Abdelwadoud-ben-kridis/smar-self-balancing-robot/images/angle.png

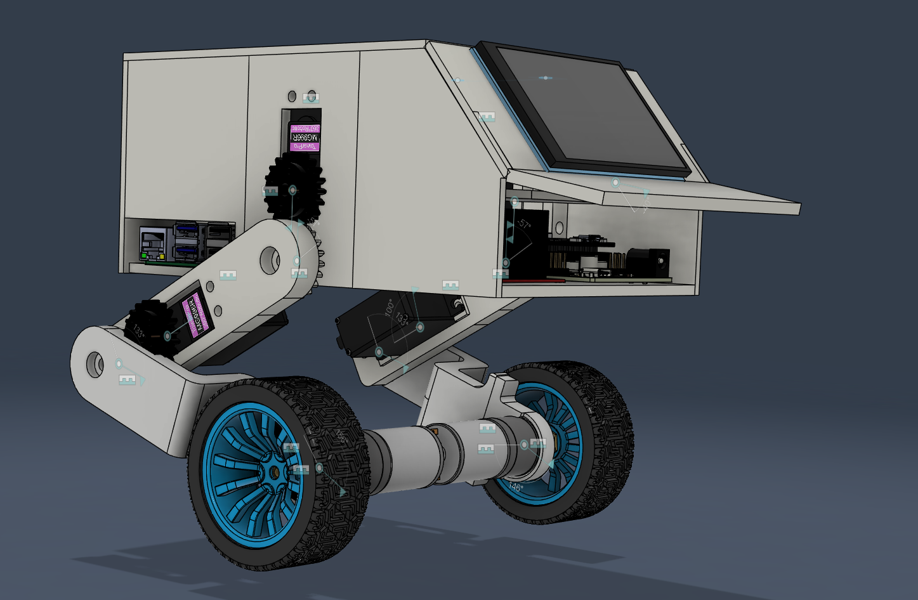
images/angle.png
