Abdelwadoud-ben-kridis/smar-self-balancing-robot/images/front.png

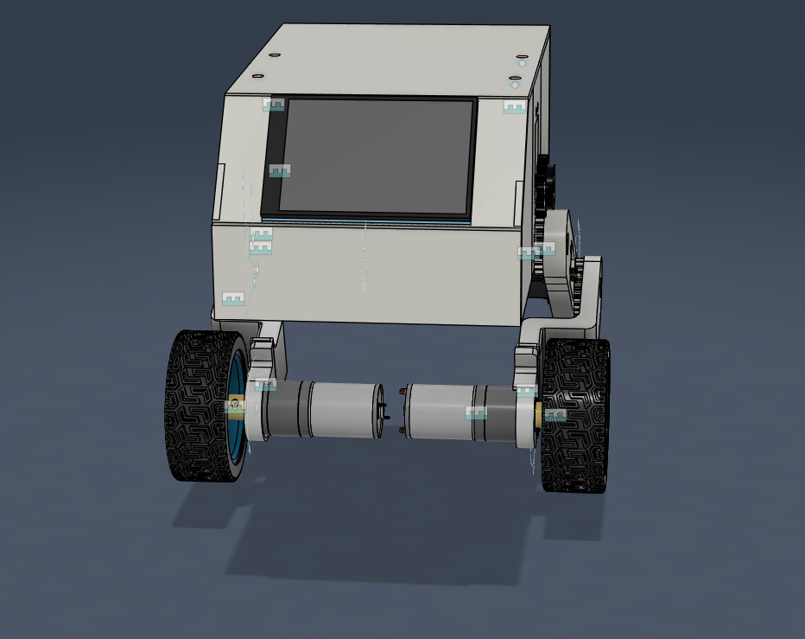
images/front.png
