Abdelwadoud-ben-kridis/smar-self-balancing-robot/images/rear.png

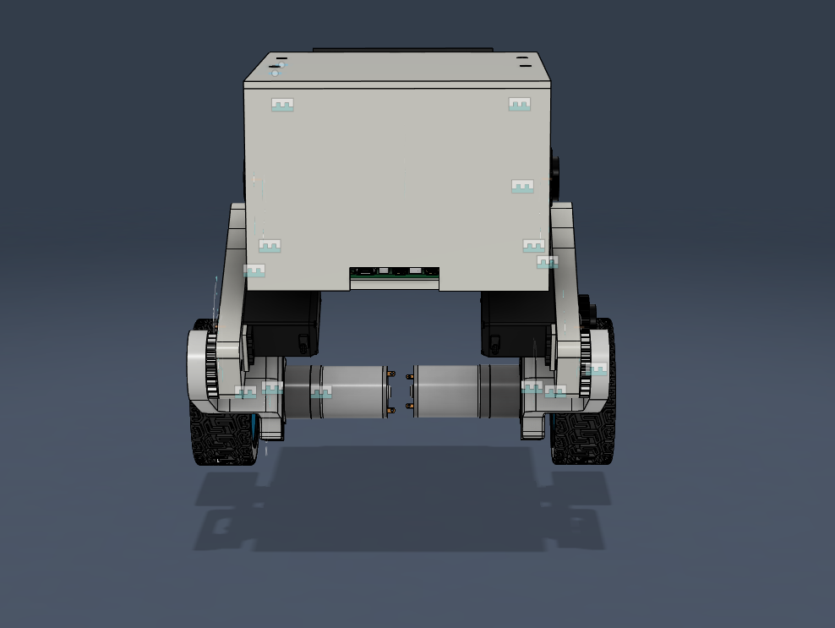
images/rear.png
