Abdelwadoud-ben-kridis/smar-self-balancing-robot/images/side-sitting.png

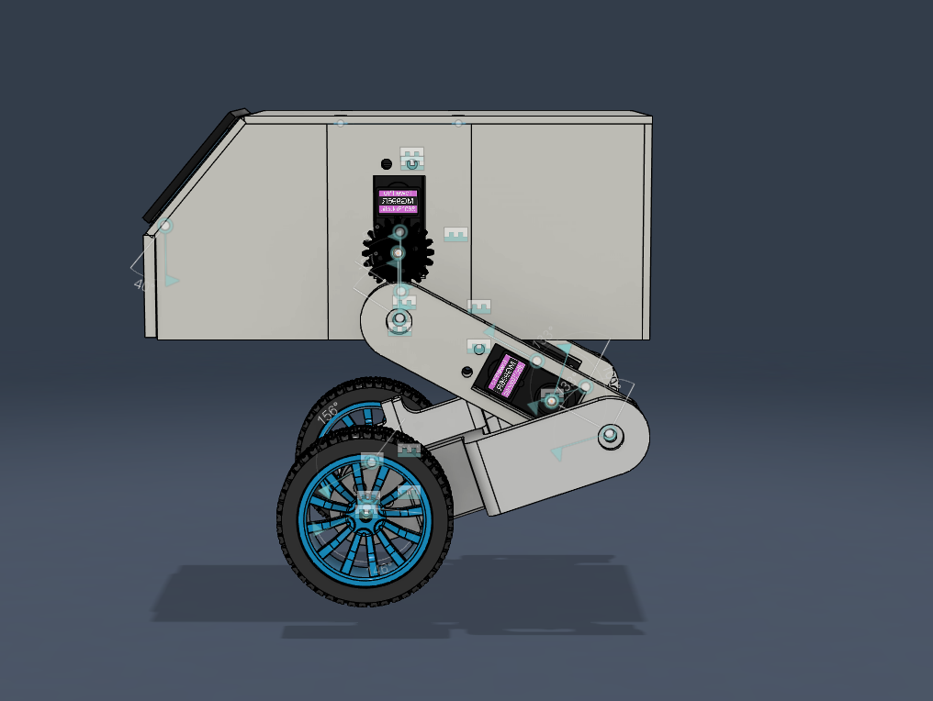
images/side-sitting.png
