Abdelwadoud-ben-kridis/smar-self-balancing-robot/images/side-standing.png

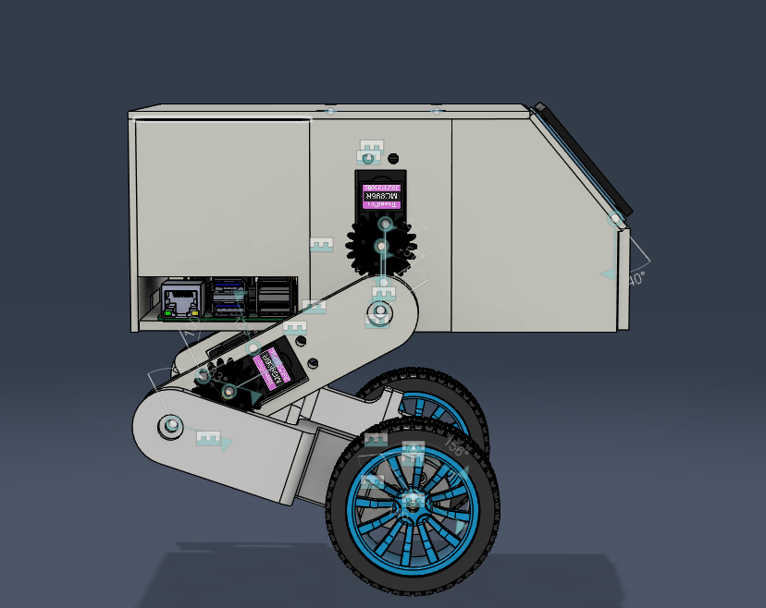
images/side-standing.png
