Abdelwadoud-ben-kridis/smar-self-balancing-robot/images/standing-clean.png

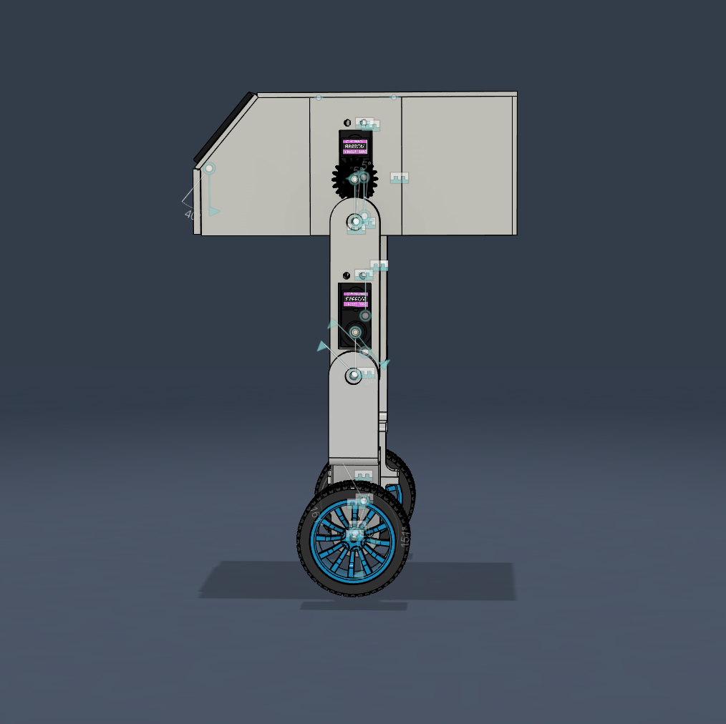
images/standing-clean.png
