Abdelwadoud-ben-kridis/smar-self-balancing-robot/images/standing-side.png

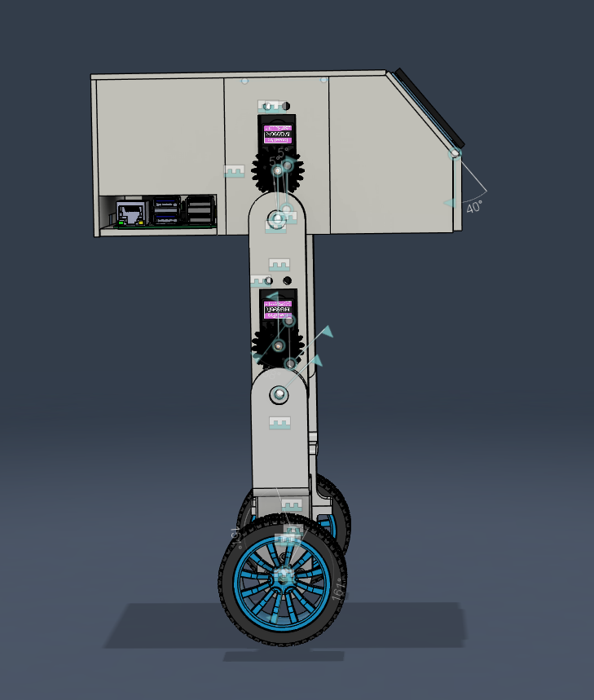
images/standing-side.png
