Abdelwadoud-ben-kridis/smar-self-balancing-robot/images/top-down.png

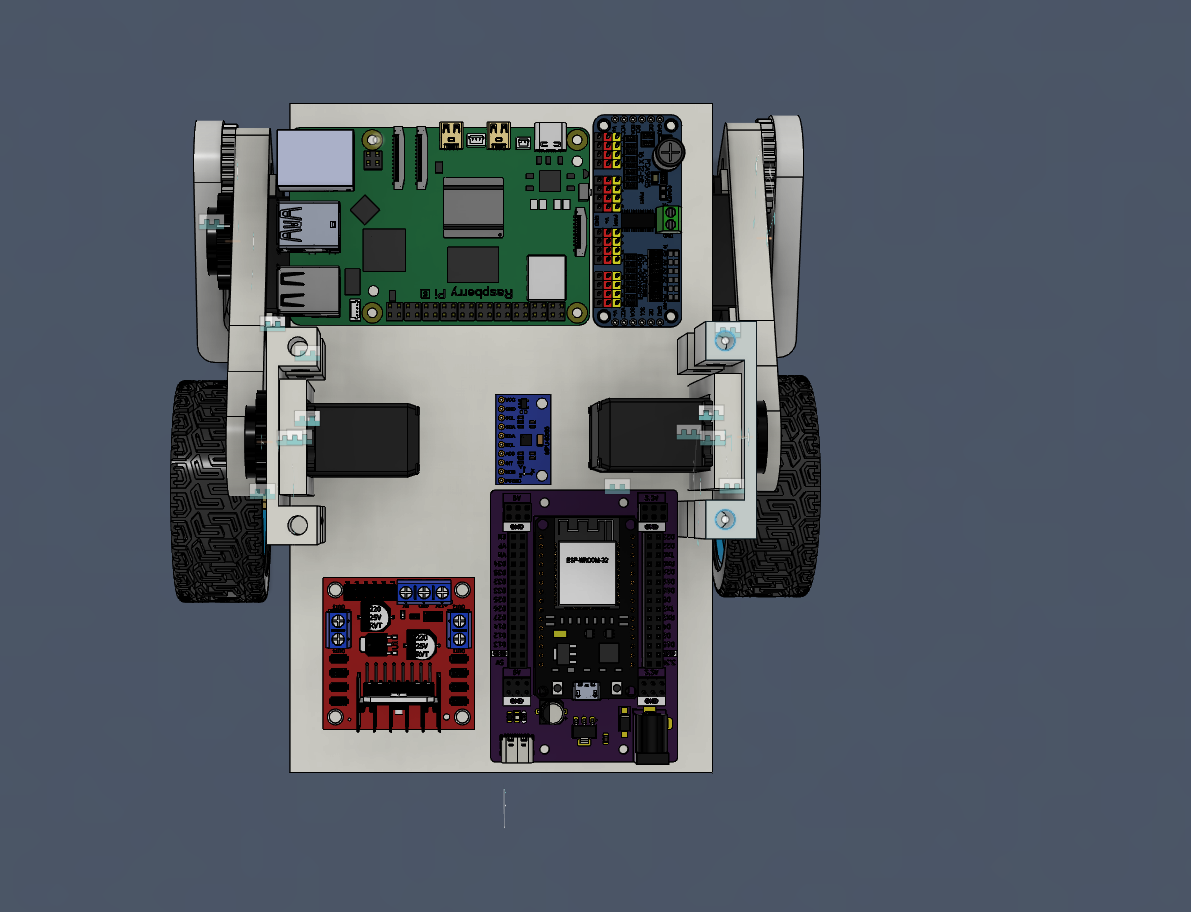
images/top-down.png
