Abdelwadoud-ben-kridis/smar-self-balancing-robot/wiring.html

01 SBR

Wiring Plan

◆ Hardware Documentation

# Complete Wiring Plan

Two-floor robot body (18×15 cm). Floor 1 (top): Raspberry Pi 5, ESP32, MPU-6500 GY module, 3.5″ SPI screen. Floor 2 (bottom): 3S battery, BMS, buck converters, L298N, PCA9685, signal conditioning PCB.

⚡

## Power Chain

11.1V · 3S

Battery feeds a BMS and a master power switch, then fans out to three regulated rails through the main 11.1 V bus.

3S 18650 → BMS → Power Switch → 11.1V Rail

Buck 1

6V

PCA9685 V+ rail and all 4× MG996R servos

Buck 2

5V

Raspberry Pi 5 (USB-C or GPIO 5V pin) and ESP32 VIN

Direct

11.1V

L298N VSS motor power — bypasses regulation

3.3V rail: ESP32 onboard regulator → 3.3V → MPU-6500 VCC, PCA9685 logic VCC, signal conditioning PCB +3V3 rail

☷

## Signal Conditioning PCB

57×60 mm

Central routing board that filters encoder signals, distributes I2C, and breaks out all ESP32 connections through a single 9-pin header.

Power input (J6): pin 1 = +3V3 from ESP32, pin 2 = GND, pin 3 = +6V from Buck 1

J1 — Encoder 1 Left Motor

- 1 +3V3 → encoder VCC
- 2 GND
- 3 ENC1_A → R1 10kΩ → C2 1nF → filtered
- 4 ENC1_B → R2 10kΩ → C3 1nF → filtered

J2 — Encoder 2 Right Motor

- 1 +3V3 → encoder VCC
- 2 GND
- 3 ENC2_A → R3 10kΩ → C6 1nF → filtered
- 4 ENC2_B → R4 10kΩ → C7 1nF → filtered

J8 — IMU MPU-6500

- 1 +3V3 → IMU VCC
- 2 GND
- 3 I2C_SDA
- 4 I2C_SCL
- 5 MPU_INT → R7 4.7kΩ pull-up

J3 — PCA9685 I2C 4-pin

- 1 +3V3
- 2 GND
- 3 I2C_SDA
- 4 I2C_SCL

J4 — PCA9685 Power 2-pin

- 1 +6V
- 2 GND

RC filter cutoff: 1/(2π × 10kΩ × 1nF) ≈ 16 kHz — kills motor PWM switching noise

### J5 — ESP32 Output Header (9-pin)

Pin | Signal | ESP32 GPIO
1 | +3V3 | —
2 | GND | —
3 | I2C_SDA | GPIO 21
4 | I2C_SCL | GPIO 22
5 | ENC1_A (filtered) | TBD
6 | ENC1_B (filtered) | TBD
7 | ENC2_A (filtered) | TBD
8 | ENC2_B (filtered) | TBD
9 | MPU_INT | TBD

⚙

## ESP32 GPIO Assignments

WROOM-32D

GPIO | Connected to | Function
21 | Signal PCB J5-3 / IMU SDA / PCA SDA | I2C SDA (400 kHz)
22 | Signal PCB J5-4 / IMU SCL / PCA SCL | I2C SCL (400 kHz)
25 | L298N ENA | Left motor speed (PWM, 1 kHz)
26 | L298N IN1 | Left motor direction 1
27 | L298N IN2 | Left motor direction 2
32 | L298N ENB | Right motor speed (PWM, 1 kHz)
33 | L298N IN3 | Right motor direction 1
4 | L298N IN4 | Right motor direction 2
TBD | Signal PCB J5-5 | ENC1_A
TBD | Signal PCB J5-6 | ENC1_B
TBD | Signal PCB J5-7 | ENC2_A
TBD | Signal PCB J5-8 | ENC2_B
TBD | Signal PCB J5-9 | MPU_INT

⏻

## L298N Motor Driver

Dual H-Bridge

L298N Pin | Connects to | Notes
VSS | 11.1V battery | Motor power
VCC | 5V | Logic power
GND | GND | —
ENA | GPIO 25 | Left motor enable / speed (PWM)
IN1 | GPIO 26 | Left motor direction
IN2 | GPIO 27 | Left motor direction
ENB | GPIO 32 | Right motor enable / speed (PWM)
IN3 | GPIO 33 | Right motor direction
IN4 | GPIO 4 | Right motor direction
OUT1+2 | Left JGA25-370 | Motor terminals
OUT3+4 | Right JGA25-370 | Motor terminals

↻

## PCA9685 Servo Driver

I2C 0x40

Powered by 6V (V+ rail) and 3.3V (VCC logic). I2C bus from ESP32 via signal conditioning PCB.

Channel | Servo | Direction
CH0 | Left knee MG996R | Normal (pulse 150–600)
CH1 | Right knee MG996R | Reversed (pulse = 750 − normal)
CH2 | Left hip MG996R | Normal
CH3 | Right hip MG996R | Reversed (pulse = 750 − normal)
CH4–15 | Unused | —

Pulse map: 0° = 150, 90° = 375, 180° = 600
Sit position: knee 80°, hip −80° • Stand position: knee 0°, hip 0°

⌖

## MPU-6500 IMU

I2C 0x68

GY breakout module plugs into signal PCB J8 (5-pin socket). Interrupt pin routed through 4.7kΩ pull-up to ESP32.

Axis Convention

Pitch rate = gyro Y (gy)
Pitch angle = atan2(ax, az)

Interrupt

INT pin → R7 4.7kΩ pull-up → J5 pin 9 → ESP32 GPIO (TBD)

π

## Raspberry Pi 5

Floor 1

Power: 5V from Buck 2 → GPIO header pin 4 (or USB-C). Comms with ESP32: UART or USB (TBD).

### 3.5″ SPI Screen (HAT-style, direct on 40-pin header)

Display SPI0

- CS BCM 8
- MISO BCM 9
- MOSI BCM 10
- SCLK BCM 11

Control

- DC BCM 25
- RST BCM 27

Touch

- CS BCM 7
- IRQ BCM 17

⚙

## JGA25-370 Motors

With Encoders

Each motor has 6 wires — 2 for the motor, 4 for the quadrature encoder.

Wire | Color | Connects to
Motor + | — | L298N OUT pins
Motor − | — | L298N OUT pins
Encoder VCC | Red | Signal PCB J1/J2 pin 1 (+3V3)
Encoder GND | Black | Signal PCB J1/J2 pin 2 (GND)
Channel A | Green | Signal PCB J1/J2 pin 3
Channel B | White | Signal PCB J1/J2 pin 4

◎

## MG996R Servos

4× Joints

Standard 3-wire servo connectors plug directly into PCA9685 channel headers.

Wire | Color | Connects to
GND | Brown | PCA9685 GND rail
Power | Red | +6V (Buck 1 via PCA9685 V+ rail)
Signal | Orange | PCA9685 channel PWM output

↑
