Abdelwadoud-ben-kridis/smar-self-balancing-robot/(commit log)

2026-05-19 feat: add complete ESP32 balance firmware (Phase 02, Steps 1-6)
    Six-module firmware for the self-balancing robot:
    - config.h: pin map, PID defaults, servo geometry, safety thresholds
    - sensors.h: MPU-6500 I2C burst read + complementary filter (100 Hz)
    - motors.h: L298N dual H-bridge via ESP32 LEDC PWM
    - servos.h: PCA9685 + sinusoidal stance interpolation (sit/stand)
    - comms.h: USB Serial debug + UART2 Pi 5 protocol + 20 Hz telemetry
    - control.ino: 100 Hz main loop with PID, state machine, fall detection
2026-05-19 Add Raspberry Pi 3.5" TFT display app with boot, face, and dashboard
    pygame app for 480x320 SPI TFT (framebuffer /dev/fb1) with three screens:
    - Boot animation: terminal-style line reveal with progress bar
    - Animated face: reactive robot eyes that respond to pitch/state
    - Telemetry dashboard: live pitch graph, motor gauges, tilt indicator
    Reads ESP32 UART telemetry (T:pitch,ml,mr,state) at 20 Hz on /dev/serial0.
    Supports a demo flag for testing with fake sinusoidal data.
2026-05-19 Add aesthetic wiring plan webpage matching site design
    Dark-themed single-page documentation with scroll-reveal sections,
    flow diagrams, connector pin cards, color-coded tables, and
    the same design tokens as the main index.html.
